janelia-modular-devices/h_bridge_controller/README.org

#+TITLE: h_bridge_controller
#+AUTHOR: Peter Polidoro
#+EMAIL: peter@polidoro.io

* Repository Information
  - Author :: Peter Polidoro
  - License :: BSD
