janelia-modular-devices/h_bridge_controller/hardware/mega/bom/bom_pcb.csv

Item | Reference(s) | Value | Quantity | Description | PartNumber | Vendor
1 | ARDUINO1 | ARDUINO_MEGA | 1 | BOARD MCU MEGA2560 | 1050-1018-ND | digikey
2 | C1 C2 C3 | 10uF | 3 | CAP CER 10UF 50V 10% X7S 1210 | 445-4536-1-ND | digikey
3 | C4 C5 C7 C8 | 0.1uF | 4 | CAP CER 0.1UF 50V 10% X7R 1210 | 478-3586-1-ND | digikey
4 | C6 C9 | 47uF | 2 | CAP TANT 47UF 35V 10% 2917 | 399-3821-1-ND | digikey
5 | D1 D10 D11 D12 D13 D14 D15 D16 D2 D3 D4 D5 D6 D7 D8 D9 | diode_schottky_40V_1A | 16 | DIODE SCHOTTKY 40V 1A SMA | SS14CT-ND | digikey
6 | L1 L2 L3 L4 L5 L6 L7 L8 L9 | LED_24V | 9 | LED 2MM 24V VERTICAL RED PC MNT | 350-1723-ND | digikey
7 | P1 | PWR_JACK_2.5x5.5 | 1 | CONN PWR JACK DC 2.5X5.5 8A T/H | CP-063BH-ND | digikey
8 | P10 P8 P9 | HEADER_01X05_SMD_SHR | 3 | CONN HEADER .100 VERT 5POS SMD | WM7205-ND | digikey
9 | P2 P3 P4 P5 | HEADER_01X03_SMD_RA | 4 | CONN HEADER 3POS R/A SMD GOLD | A100890CT-ND | digikey
10 | P6 | HEADER_01X02_SMD_RA | 1 | CONN HEADER 2POS R/A SMD GOLD | A100903CT-ND | digikey
11 | P7 | BNC_DOUBLE_RA | 1 | CONN BNC JACK R/A 75 OHM PCB | ACX1655-ND | digikey
12 | R1 R2 R3 R4 | 0.5 | 4 | RES SMD 0.5 OHM 1% 1W 2010 | CSRN2010FKR500CT-ND | digikey
13 | R7 R8 R9 | 180 | 3 | RES SMD 180 OHM 5% 1/2W 1210 | P180VCT-ND | digikey
14 | REG1 | CONV_DC_DC_12V_1A | 1 | CONV DC/DC 1A 12V OUT SIP VERT | 945-1392-5-ND | digikey
15 | SW1 | SPST_SLIDE_AS | 1 | SWITCH SLIDE SPST 0.4VA 28V | 360-2610-ND | digikey
16 | T1 T2 T3 T4 | TERM_BLK_ANG_2_PIN | 4 | TERMINAL BLOCK PCB 2POS 5.08MM | 277-5716-ND | digikey
17 | U1 U2 | L298 | 2 | IC BRIDGE DRIVER PAR 20POWERSO | 497-3624-1-ND | digikey
