janelia-modular-devices/h_bridge_controller/hardware/mega/bom/bom_pcb_add.csv

Item | Function | Quantity | Description | PartNumber | Vendor
1 | ARDUINO | 2 | CONN HDR VERT 50POS .100 SNGL | SAM1055-50-ND | digikey
2 | ARDUINO | 1 | CABLE USB A-B MALE 1M 2.0 VERS | AE1462-ND | digikey
3 | POWER | 1 | AC/DC DESKTOP ADAPTER 24V 90W | 62-1187-ND | digikey
4 | POWER | 1 | CORD 3COND NEMA PLUG 320-C5 | 993-1037-ND | digikey
5 | SENSOR | 3 | SWITCH SLOTTED OPTICAL WIDE GAP | 365-1935-ND | digikey
6 | CONNECTOR | 3 | CONN HOUSING 5POS .100 W/LATCH | WM2903-ND | digikey
7 | CONNECTOR | 15 | CONN SOCKET 24-30AWG CRIMP 30AU | WM2572-ND | digikey
