janelia-modular-devices/h_bridge_controller/hardware/mega/schematic/h_bridge_controller.pdf

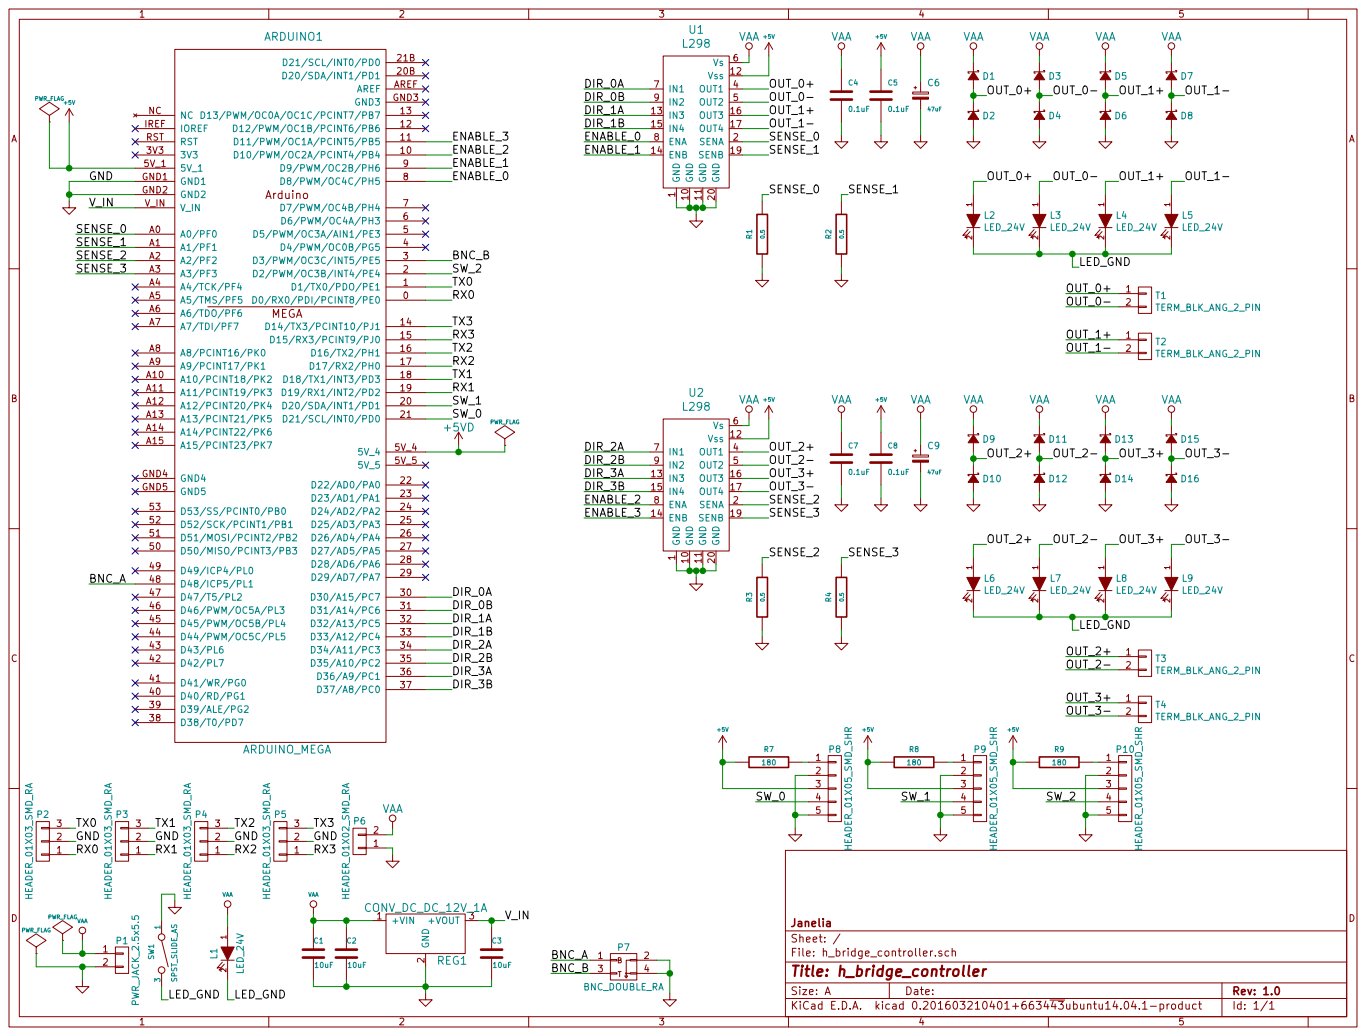
[picture p1: page 1]

File: h_bridge_controller.sch Sheet: / Janelia
