janelia-modular-devices/h_bridge_controller/(list of files, drawings)

Other design files:
hardware/mega/h_bridge_controller.dsn
