janelia-modular-devices/h_bridge_controller/hardware/mega/h_bridge_controller.kicad_pcb

## KiCad design hardware/mega/h_bridge_controller.kicad_pcb (2016-04-11)

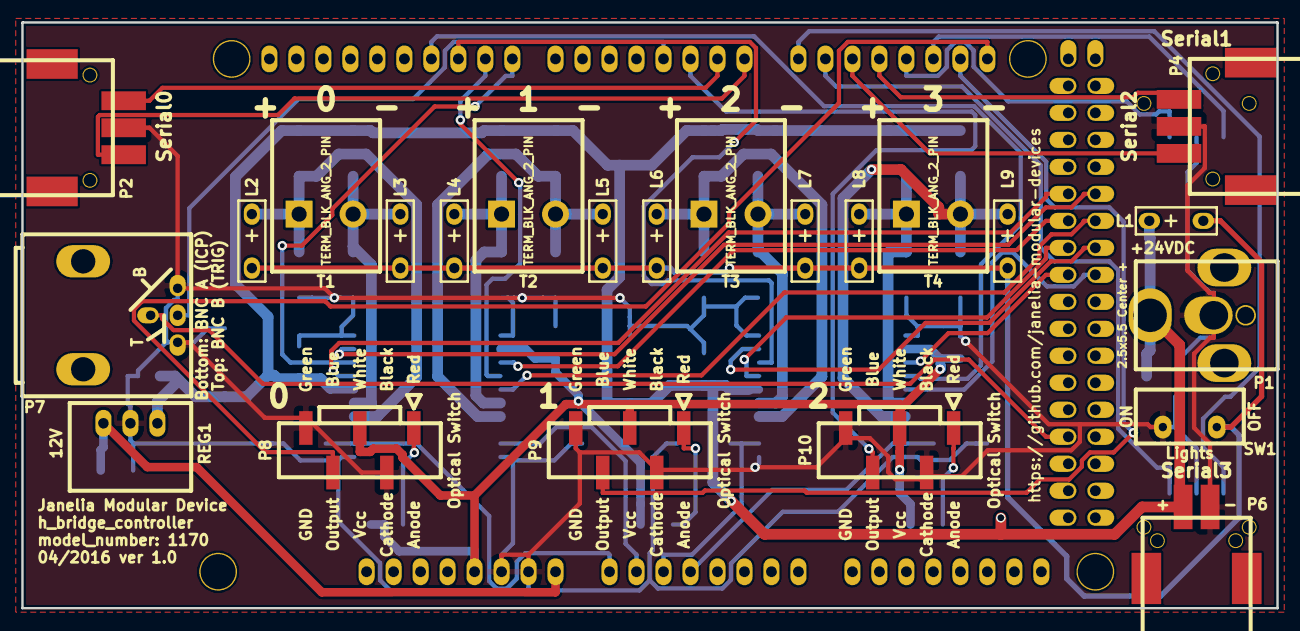
[picture p2: board h_bridge_controller.kicad_pcb from above]

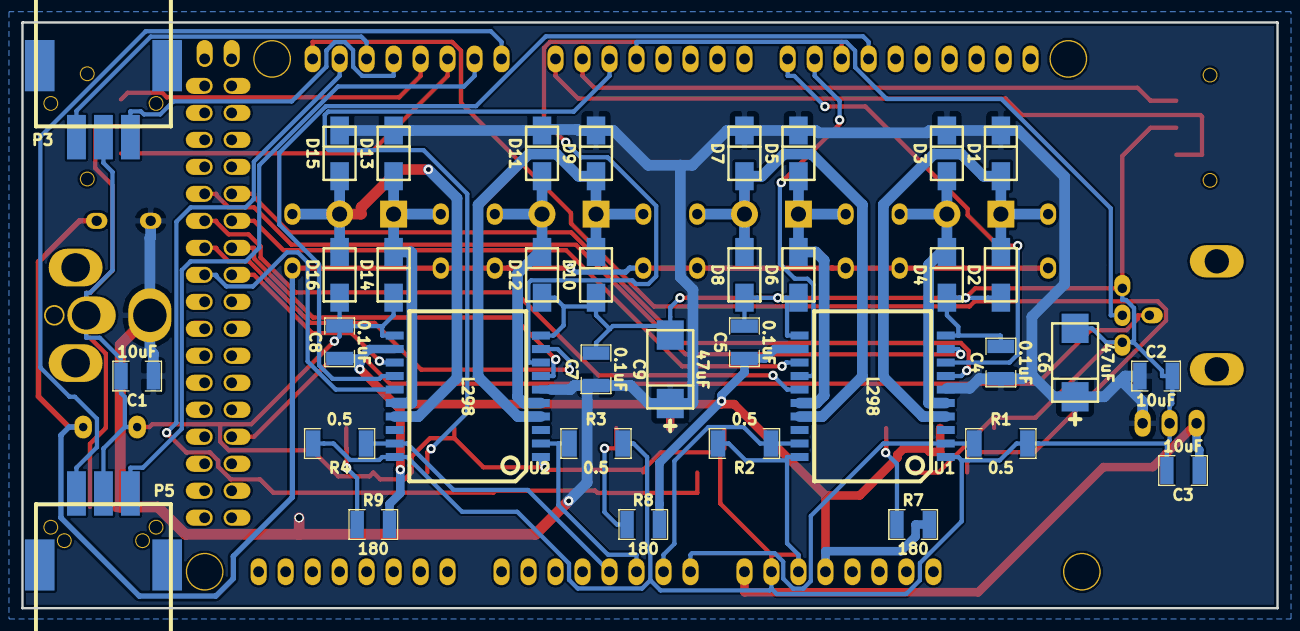
[picture p3: board h_bridge_controller.kicad_pcb from below]

Board: 2 copper layers, 118.1 x 55.1 mm, 60 parts (36 on the bottom side), 45 nets.

Parts:
ARDUINO1: ARDUINO_MEGA; ARDUINO_MEGA_SHIELD
C1, C2, C3: 10uF; SM1210
C4, C5, C7, C8: 0.1uF; SM1210
C6, C9: 47uF; SM2917_POL
D1, D2, D3, D4, D5, D6, D7, D8, D9, D10, D11, D12, D13, D14, D15, D16: diode_schottky_40V_1A; DO-214AC(SMA)
L1, L2, L3, L4, L5, L6, L7, L8, L9: LED_24V; LED_555-3XXX
P1: PWR_JACK_2.5x5.5; DCJACK_2PIN_HIGHCURRENT
P2, P3, P4, P5: HEADER_01X03_SMD_RA; Header_3_Pin_SMD_RA
P6: HEADER_01X02_SMD_RA; Header_2_Pin_SMD_RA
P7: BNC_DOUBLE_RA; BNC_DOUBLE
P8, P9, P10: HEADER_01X05_SMD_SHR; Header_Shrouded_5_Pin_SMD
R1, R2, R3, R4: 0.5; SM2010
R7, R8, R9: 180; SM1210
REG1: CONV_DC_DC_12V_1A; DC_DC_CONV_R78C
SW1: SPST_SLIDE_AS
T1, T2, T3, T4: TERM_BLK_ANG_2_PIN
U1, U2: L298; POWERSO20

Connections:
+5V: ARDUINO1.5V_1, C5.1, C8.1, P8.3, P9.3, P10.3, R7.2, R8.2, R9.2, U1.12, U2.12
/BNC_A: ARDUINO1.48, P7.1
/BNC_B: ARDUINO1.3, P7.3
/DIR_0A: ARDUINO1.30, U1.7
/DIR_0B: ARDUINO1.31, U1.9
/DIR_1A: ARDUINO1.32, U1.13
/DIR_1B: ARDUINO1.33, U1.15
/DIR_2A: ARDUINO1.34, U2.7
/DIR_2B: ARDUINO1.35, U2.9
/DIR_3A: ARDUINO1.36, U2.13
/DIR_3B: ARDUINO1.37, U2.15
/ENABLE_0: ARDUINO1.8, U1.8
/ENABLE_1: ARDUINO1.9, U1.14
/ENABLE_2: ARDUINO1.10, U2.8
/ENABLE_3: ARDUINO1.11, U2.14
/LED_GND: L1.2, L2.2, L3.2, L4.2, L5.2, L6.2, L7.2, L8.2, L9.2, SW1.3
/OUT_0+: D1.2, D2.1, L2.1, T1.1, U1.4
/OUT_0-: D3.2, D4.1, L3.1, T1.2, U1.5
/OUT_1+: D5.2, D6.1, L4.1, T2.1, U1.16
/OUT_1-: D7.2, D8.1, L5.1, T2.2, U1.17
/OUT_2+: D9.2, D10.1, L6.1, T3.1, U2.4
/OUT_2-: D11.2, D12.1, L7.1, T3.2, U2.5
/OUT_3+: D13.2, D14.1, L8.1, T4.1, U2.16
/OUT_3-: D15.2, D16.1, L9.1, T4.2, U2.17
/RX0: ARDUINO1.0, P2.1
/RX1: ARDUINO1.19, P3.1
/RX2: ARDUINO1.17, P4.1
/RX3: ARDUINO1.15, P5.1
/SENSE_0: ARDUINO1.A0, R1.1, U1.2
/SENSE_1: ARDUINO1.A1, R2.1, U1.19
/SENSE_2: ARDUINO1.A2, R3.1, U2.2
/SENSE_3: ARDUINO1.A3, R4.1, U2.19
/SW_0: ARDUINO1.21, P8.4
/SW_1: ARDUINO1.20, P9.4
/SW_2: ARDUINO1.2, P10.4
/TX0: ARDUINO1.1, P2.3
/TX1: ARDUINO1.18, P3.3
/TX2: ARDUINO1.16, P4.3
/TX3: ARDUINO1.14, P5.3
/V_IN: ARDUINO1.V_IN, C3.1, REG1.3
GND: ARDUINO1.GND1, ARDUINO1.GND2, C1.2, C2.2, C3.2, C4.2, C5.2, C6.2, C7.2, C8.2, C9.2, D2.2, D4.2, D6.2, D8.2, D10.2, D12.2, D14.2, D16.2, P1.2, P2.2, P3.2, P4.2, P5.2, P6.1, P7.2, P7.4, P8.2, P8.5, P9.2, P9.5, P10.2, P10.5, R1.2, R2.2, R3.2, R4.2, REG1.2, SW1.1, U1.1, U1.10, U1.11, U1.20, U2.1, U2.10, U2.11, U2.20
unnamed: P8.1, R7.1
unnamed: P9.1, R8.1
unnamed: P10.1, R9.1
VAA: C1.1, C2.1, C4.1, C6.1, C7.1, C9.1, D1.1, D3.1, D5.1, D7.1, D9.1, D11.1, D13.1, D15.1, L1.1, P1.1, P6.2, REG1.1, U1.6, U2.6
