janelia-modular-devices/h_bridge_controller/firmware/firmware.ino

// h_bridge_controller
#include "Flash.h"
#include <EEPROM.h>
#include "Streaming.h"
#include "ArduinoJson.h"
#include "JsonSanitizer.h"
#include "JsonStream.h"
#include "Array.h"
#include "Vector.h"
#include "MemoryFree.h"
#include "ConstantVariable.h"
#include "SavedVariable.h"
#include "ModularServer.h"
#include "EventController.h"
#include "Constants.h"
#include "Callbacks.h"
#include "Controller.h"

#include "IndexedContainer.h"


// See README.md for more information

void setup()
{
  controller.setup();
}

void loop()
{
  controller.update();
}
