janelia-modular-devices/h_bridge_controller/(commit log)

2016-02-25 Added interrupts.
2016-02-26 Added pwm method.
2016-03-15 Added initial pcb files and moved firmware files.
    [bom_pcb.csv, bom_pcb_add.csv, digikey_order.csv, digikey_order_pcb.csv, digikey_order_pcb_add.csv, h_bridge_controller.dsn, h_bridge_controller.kicad_pcb, h_bridge_controller.sch]
2016-03-15 Progress towards pcb v1.0.
    [h_bridge_controller.kicad_pcb, h_bridge_controller.sch]
2016-04-06 Use relay_controller as pcb base.
    [bom_pcb.csv, bom_pcb_add.csv, digikey_order.csv, digikey_order_pcb.csv, digikey_order_pcb_add.csv, h_bridge_controller.dsn, h_bridge_controller.kicad_pcb, h_bridge_controller.sch]
2016-04-06 relay_controller -> h_bridge_controller.
    [h_bridge_controller.dsn, h_bridge_controller.kicad_pcb, h_bridge_controller.sch]
2016-04-06 Progress towards pcb1.0.
    [h_bridge_controller.sch]
2016-04-08 More progress towards pcb1.0.
    [h_bridge_controller.kicad_pcb, h_bridge_controller.sch]
2016-04-11 Finished pcb1.0.
    [h_bridge_controller-B.Cu.gbl, h_bridge_controller-B.Mask.gbs, h_bridge_controller-B.SilkS.gbo, h_bridge_controller-F.Cu.gtl, h_bridge_controller-F.Mask.gts, h_bridge_controller-F.SilkS.gto, h_bridge_controller-NPTH.drl, h_bridge_controller.drl]
2016-04-11 Updated bom.
    [bom_pcb.csv, bom_pcb_add.csv, digikey_order.csv, digikey_order_pcb.csv, digikey_order_pcb_add.csv]
2016-04-26 Modified for modular device hardware.
2016-09-21 pcb -> hardware.
    [bom_pcb.csv, bom_pcb_add.csv, digikey_order.csv, digikey_order_pcb.csv, digikey_order_pcb_add.csv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]
2016-09-22 Moved to mega hardware directory.
    [bom_pcb.csv, bom_pcb_add.csv, digikey_order.csv, digikey_order_pcb.csv, digikey_order_pcb_add.csv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]
